LacieUnlam/cartel-led/README.txt

Repositorio GIT del LACIE

NOMBRE PROYECTO:
DESCRIPCION CORTA:
URL WIKI:

Estructura de directorios sugerida del GIT:

* kicad: Archivos PCBs del kicad. 
 ** prototipo1: Colocar gerbers, BOM, pdfs del circuito fabricado, fotos, renders.
 ** prototipo2: Si se hace una segunda fabricación  con correcciones.
 ** hojas_datos: Hojas de datos de los componentes usados en el diseño.
 ** lib: bibliotecas del esquemático.
 ** footp: Módulos del PCB. Unificar los módulos en un único archivo.
    *** 3d: Vistas 3D.
* doc: Documentación asociada directamente al desarrolo y al contenido
       del GIT. No repetir la info de la wiki. Se trata de documentación
       generada por el grupo de trabajo o participantes. 
* info: Información relevante y más importante utilizada para el diseño, que
        ayuda a comprenderlo y justificarlo.
        Es información realizada por terceros (si es propia va en doc).
        Notas de aplicación, documentos de terceros, componentes similares
        evaluados, artículos en revistas, etc.

README.txt: Es este archivo, que debe modificarse y actualizarse con los datos   
            del proyecto.
