LacieUnlam/cartel-led/(list of files, cad)

Other CAD files:
PC/cartelled_pcsoft/CommPort/CommPortRegC6.obj
PC/cartelled_pcsoft/CommPort/IOThread.obj
PC/cartelled_pcsoft/CommPort/TimeOuts.obj
PC/cartelled_pcsoft/CommPort/CommPort.obj
