LacieUnlam/cartel-led/Hard/Kicad_modulo/cartel1.sch

## KiCad design Hard/Kicad_modulo/cartel1.sch (2019-09-17, an earlier design)

Schematic: cartel1.sch

Parts:
C1, C2: 100nf
D1, D2, D3, D4, D5, D6, D7, D8, D9, D10, D11, D12, D13, D14, D15, D16, D17, D18, D19, D20, D21, D22, D23, D24, D25, D26, D27, D28, D29, D30, D31, D32: LED
P1, P2: bus
P3: Dinput
P4: Doutput
U1, U2, U3, U4: 74LS595

Notes on the sheet:
Nota: C1 y C2 son capacitores SMD de encapsulados 1206 pero se pueden soldar encapsulados 0805.
pin1
VISTA DEL CONECTOR LADO COBRE
LOAD
CLK
GND
FILA 4 (INFERIOR)
FILA 3
FILA 2
FILA 1 (SUPERIOR)
BUS CONTROL Y ALIMENTACION
VISTA SUPERIOR LADO COBRE
DETALLE DE MONTAJE
Tornillo 1/8"
PLaca lado LEDs
Placa lado cobre
Separador plástico
Varilla Aluminio roscada
SALIDA DATO
ENTRADA DATO
DATO SERIE SALIDA
DATO SERIE ENTRADA
Soldadura
PINES
Plástico conector 4x2
Plastico conector 4x2
Lado leds
Lado cobre
VISTA LATERAL
Cable plano
Nota: Los integrados se sueldan sin zócalo.
Nota: Los leds se sueldan apoyados sobre el PCB. No se deja espacio entre la placa y el led.
Nota: Los pines se montan hacia el lado del cobre, al revés que lo normal.
Nota: Los conectores de 4x2 se conectan entre sí y hacia el control central por cable plano. Por eso en el PCB se pueden observar líneas sin rutear (la conecta el cable por fuera del PCB).
