LacieUnlam/cartel-led/Hard/control/3 lineas/hard_control.sch

## KiCad design Hard/control/3 lineas/hard_control.sch (2015-05-21)


Parts:
B1: RB1A; rectifier-RB1A
C1: 4.7uf tan
C2, C10: 100nf
C3, C4: 22pf
C5, C6, C7, C8, C9: C
D1: LED
IC1: ATMEGA32-P; DIL40
J1: DB9 FEMALE
LINE_POWER_1, LINE_POWER_2, LINE_POWER_3, LINE_POWER_4: CONN_2
P1: CONN_2
P2, P3, P4, P5: CONN_4X2
PSI1: CONN_3X2
R1, R2, R3: 330
R4: 1K
R5: 500
R6: 10K
Reset1: SW_PUSH
SERIAL_CONN1: CONN_4
U1: MAX202
U2: 7805
U3: 74LS541
X1: CRYSTAL

Connections:
+5V: C1.1, C2.1, C5.2, C7.1, IC1.10 (VCC), IC1.30 (AVCC), PSI1.2, R5.1, R6.1, U1.16 (VCC), U2.VO, U3.20 (VCC)
GND: B1.-, C1.2, C2.2, C3.2, C4.2, C5.1, C9.1, C10.1, D1.2 (K), IC1.11 (GND), IC1.31 (AGND), J1.5, LINE_POWER_1.2 (PM), LINE_POWER_2.2 (PM), LINE_POWER_3.2 (PM), LINE_POWER_4.2 (PM), P2.1, P2.2, P2.4, P3.1, P3.2, P3.4, P4.1, P4.2, P4.4, P5.1, P5.2, P5.4, PSI1.6, Reset1.1, U1.15 (GND), U2.GND, U3.1 (G1), U3.10 (GND), U3.19 (G2)
MISO: IC1.7 ((MISO)PB6), R1.1
MOSI: IC1.6 ((MOSI)PB5), R3.2
unnamed: B1.+, U2.VI
unnamed: B1.AC1, P1.2 (PM)
unnamed: B1.AC2, P1.1
unnamed: C3.1, IC1.12 (XTAL2), X1.2
unnamed: C4.1, IC1.13 (XTAL1), X1.1
unnamed: C6.1, U1.1 (C1+)
unnamed: C6.2, U1.3 (C1-)
unnamed: C7.2, U1.2 (V+)
unnamed: C8.1, U1.4 (C2+)
unnamed: C8.2, U1.5 (C2-)
unnamed: C9.2, U1.6 (V-)
unnamed: D1.1 (A), R5.2
unnamed: LINE_POWER_1.1, P2.3, P2.5, P2.6
unnamed: LINE_POWER_2.1, P3.3, P3.5, P3.6
unnamed: LINE_POWER_3.1, P4.3, P4.5, P4.6
unnamed: LINE_POWER_4.1, P5.3, P5.5, P5.6
unnamed: PSI1.1, R1.2
unnamed: PSI1.3, R2.2
unnamed: PSI1.4, R3.1
unnamed: PSI1.5, R4.2
RXD-RS232: J1.3, U1.8 (R2IN)
RXD-TTL: IC1.14 ((RXD)PD0), U1.9 (R2OUT)
Reset: C10.2, IC1.9 (~RESET), R4.1, R6.2, Reset1.2
SCK: IC1.8 ((SCK)PB7), R2.1
SR_LC: IC1.28 ((TOSC1)PC6), U3.2 (A0), U3.4 (A2), U3.6 (A4), U3.8 (A6)
SR_LC_1: P2.7, U3.18 (Y0)
SR_LC_2: P3.7, U3.16 (Y2)
SR_LC_3: P4.7, U3.14 (Y4)
SR_LC_4: P5.7, U3.12 (Y6)
SR_SC: IC1.27 ((TDI)PC5), U3.3 (A1), U3.5 (A3), U3.7 (A5), U3.9 (A7)
SR_SC_1: P2.8, U3.17 (Y1)
SR_SC_2: P3.8, U3.15 (Y3)
SR_SC_3: P4.8, U3.13 (Y5)
SR_SC_4: P5.8, U3.11 (Y7)
SR_SERIAL_1: IC1.23 ((SDA)PC1), SERIAL_CONN1.1
SR_SERIAL_2: IC1.24 ((TCK)PC2), SERIAL_CONN1.2
SR_SERIAL_3: IC1.25 ((TMS)PC3), SERIAL_CONN1.3
SR_SERIAL_4: IC1.26 ((TDO)PC4), SERIAL_CONN1.4
TXD-RS232: J1.2, U1.7 (T2OUT)
TXD-TTL: IC1.15 ((TXD)PD1), U1.10 (T2IN)

Notes on the sheet:
SPI
PUERTO SERIE
RS232
