LacieUnlam/cartel-led/Hard/control/full/rescue-backup/hard_control-2019-09-07-13-09-32.sch

## KiCad design Hard/control/full/rescue-backup/hard_control-2019-09-07-13-09-32.sch (2015-10-20)

Schematic: hard_control-2019-09-07-13-09-32.sch

Parts:
B1: RB1A; rectifier-RB1A
C1: 4.7uf tan
C2, C10: 100nf
C3, C4: 22pf
C5, C6, C7, C8, C9: C
D1: LED
DIGI_PWR_1: CONN_2
IC1: ATMEGA32-P; DIL40
J1: DB9 FEMALE
LINE_POWER_1, LINE_POWER_2, LINE_POWER_3, LINE_POWER_4, LINE_POWER_5, LINE_POWER_6: CONN_2
P1, P2, P3, P4, P5, P6: CONN_5X2
PSI1: CONN_3X2
R1, R2, R3: 330
R4: 1K
R5: 500
R6: 10K
Reset1: SW_PUSH
SERIAL_CONN1: CONN_6
U1: MAX202
U2: 7805
U3, U4: 74LS541
X1: CRYSTAL

Notes on the sheet:
SPI
PUERTO SERIE
RS232
