LacieUnlam/cartel-led/Firm/Src/ArialBlack_14.h

/*
 *
 * arialblack_14
 *
 * created with FontCreator
 * written by F. Maximilian Thiele
 *
 * http://www.apetech.de/fontCreator
 * me@apetech.de
 *
 * File Name           : ArialBlack_14.h
 * Date                : 30.10.2013
 * Font size in bytes  : 9762
 * Font width          : 10
 * Font height         : 14
 * Font first char     : 32
 * Font last char      : 128
 * Font used chars     : 96
 *
 * The font data are defined as
 *
 * struct _FONT_ {
 *     uint16_t   font_Size_in_Bytes_over_all_included_Size_it_self;
 *     uint8_t    font_Width_in_Pixel_for_fixed_drawing;
 *     uint8_t    font_Height_in_Pixel_for_all_characters;
 *     unit8_t    font_First_Char;
 *     uint8_t    font_Char_Count;
 *
 *     uint8_t    font_Char_Widths[font_Last_Char - font_First_Char +1];
 *                  // for each character the separate width in pixels,
 *                  // characters < 128 have an implicit virtual right empty row
 *
 *     uint8_t    font_data[];
 *                  // bit field of all characters
 */

#include <inttypes.h>
#include <avr/pgmspace.h>

#ifndef ARIALBLACK_14_H
#define ARIALBLACK_14_H

#define ARIALBLACK_14_WIDTH 10
#define ARIALBLACK_14_HEIGHT 14

const static uint8_t arialblack_14[] PROGMEM = {
    0x26, 0x22, // size
    0x0A, // width
    0x0E, // height
    0x20, // first char
    0x60, // char count
    
    // char widths
    0x00, 0x03, 0x07, 0x08, 0x07, 0x0C, 0x0A, 0x03, 0x05, 0x05, 
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
    0xF0, 0xFC, 0xFC, 0x0E, 0x06, 0x66, 0x66, 0xEE, 0xEC, 0xE8, 0x00, 0x0C, 0x0C, 0x1C, 0x18, 0x18, 0x18, 0x1C, 0x0C, 0x0C, // 71
    0xFE, 0xFE, 0xFE, 0x60, 0x60, 0x60, 0x60, 0xFE, 0xFE, 0xFE, 0x1C, 0x1C, 0x1C, 0x00, 0x00, 0x00, 0x00, 0x1C, 0x1C, 0x1C, // 72
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
    
};

#endif
