LacieUnlam/cartel-led/Firm/Src/BroadwayBT_8.h

/*
 *
 * BroadwayBT_8
 *
 * created with FontCreator
 * written by F. Maximilian Thiele
 *
 * http://www.apetech.de/fontCreator
 * me@apetech.de
 *
 * File Name           : BroadwayBT_8.h
 * Date                : 25.09.2012
 * Font size in bytes  : 4062
 * Font width          : 10
 * Font height         : 9
 * Font first char     : 32
 * Font last char      : 128
 * Font used chars     : 96
 *
 * The font data are defined as
 *
 * struct _FONT_ {
 *     uint16_t   font_Size_in_Bytes_over_all_included_Size_it_self;
 *     uint8_t    font_Width_in_Pixel_for_fixed_drawing;
 *     uint8_t    font_Height_in_Pixel_for_all_characters;
 *     unit8_t    font_First_Char;
 *     uint8_t    font_Char_Count;
 *
 *     uint8_t    font_Char_Widths[font_Last_Char - font_First_Char +1];
 *                  // for each character the separate width in pixels,
 *                  // characters < 128 have an implicit virtual right empty row
 *
 *     uint8_t    font_data[];
 *                  // bit field of all characters
 */

#include <inttypes.h>
#include <avr/pgmspace.h>

#ifndef BROADWAYBT_8_H
#define BROADWAYBT_8_H

#define BROADWAYBT_8_WIDTH 10
#define BROADWAYBT_8_HEIGHT 9

const static uint8_t BroadwayBT_8[] PROGMEM = {
    0x0F, 0xDE, // size
    0x0A, // width
    0x09, // height
    0x20, // first char
    0x60, // char count
    
    // char widths
    0x00, 0x02, 0x03, 0x06, 0x04, 0x06, 0x06, 0x01, 0x02, 0x02, 
    0x03, 0x05, 0x02, 0x03, 0x02, 0x03, 0x05, 0x04, 0x05, 0x05, 
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
    0x7E, 0x7E, 0x7E, 0x0A, 0x0A, 0x00, 0x00, 0x00, 0x00, 0x00, // 70
    0x3C, 0x7E, 0x7E, 0x42, 0x54, 0x30, 0x00, 0x00, 0x00, 0x00, 0x00, 0x00, // 71
    0x7E, 0x7E, 0x7E, 0x04, 0x04, 0x7E, 0x00, 0x00, 0x00, 0x00, 0x00, 0x00, // 72
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
    
};

#endif
