LacieUnlam/cartel-led/Firm/Src/BanckGothicLtBT_8.h

/*
 *
 * BanckGothicLtBT_8
 *
 * created with FontCreator
 * written by F. Maximilian Thiele
 *
 * http://www.apetech.de/fontCreator
 * me@apetech.de
 *
 * File Name           : BanckGothicLtBT_8.h
 * Date                : 25.09.2012
 * Font size in bytes  : 2958
 * Font width          : 10
 * Font height         : 8
 * Font first char     : 32
 * Font last char      : 128
 * Font used chars     : 96
 *
 * The font data are defined as
 *
 * struct _FONT_ {
 *     uint16_t   font_Size_in_Bytes_over_all_included_Size_it_self;
 *     uint8_t    font_Width_in_Pixel_for_fixed_drawing;
 *     uint8_t    font_Height_in_Pixel_for_all_characters;
 *     unit8_t    font_First_Char;
 *     uint8_t    font_Char_Count;
 *
 *     uint8_t    font_Char_Widths[font_Last_Char - font_First_Char +1];
 *                  // for each character the separate width in pixels,
 *                  // characters < 128 have an implicit virtual right empty row
 *
 *     uint8_t    font_data[];
 *                  // bit field of all characters
 */

#include <inttypes.h>
#include <avr/pgmspace.h>

#ifndef BANCKGOTHICLTBT_8_H
#define BANCKGOTHICLTBT_8_H

#define BANCKGOTHICLTBT_8_WIDTH 10
#define BANCKGOTHICLTBT_8_HEIGHT 8

const static uint8_t BanckGothicLtBT_8[] PROGMEM = {
    0x0B, 0x8E, // size
    0x0A, // width
    0x08, // height
    0x20, // first char
    0x60, // char count
    
    // char widths
    0x00, 0x01, 0x01, 0x05, 0x04, 0x06, 0x05, 0x01, 0x02, 0x02, 
    0x03, 0x05, 0x01, 0x02, 0x01, 0x02, 0x04, 0x02, 0x04, 0x04, 
    0x05, 0x04, 0x04, 0x04, 0x04, 0x04, 0x01, 0x01, 0x05, 0x05, 
    0x05, 0x03, 0x07, 0x05, 0x04, 0x04, 0x05, 0x04, 0x04, 0x05, 
    0x05, 0x01, 0x04, 0x05, 0x04, 0x05, 0x05, 0x05, 0x04, 0x05, 
    0x04, 0x04, 0x05, 0x04, 0x05, 0x06, 0x05, 0x05, 0x04, 0x02, 
    0x02, 0x02, 0x05, 0x04, 0x02, 0x05, 0x04, 0x04, 0x04, 0x04, 
    0x03, 0x04, 0x04, 0x01, 0x03, 0x04, 0x03, 0x04, 0x04, 0x04, 
    0x04, 0x04, 0x03, 0x04, 0x04, 0x04, 0x04, 0x06, 0x04, 0x05, 
    0x04, 0x03, 0x01, 0x03, 0x05, 0x04, 
    
    // font data
    0x2C, // 33
    0x03, // 34
    0x34, 0x1C, 0x37, 0x1F, 0x14, // 35
    0x5C, 0x7E, 0x34, 0x34, // 36
    0x0C, 0x2C, 0x10, 0x08, 0x34, 0x30, // 37
    0x30, 0x2C, 0x34, 0x14, 0x30, // 38
    0x03, // 39
    0x18, 0x24, // 40
    0x24, 0x18, // 41
    0x08, 0x04, 0x08, // 42
    0x08, 0x08, 0x3E, 0x08, 0x08, // 43
    0x60, // 44
    0x10, 0x10, // 45
    0x20, // 46
    0x38, 0x04, // 47
    0x3C, 0x24, 0x24, 0x3C, // 48
    0x04, 0x3C, // 49
    0x3C, 0x34, 0x34, 0x3C, // 50
    0x24, 0x24, 0x2C, 0x34, // 51
    0x18, 0x18, 0x14, 0x3C, 0x10, // 52
    0x2C, 0x2C, 0x2C, 0x38, // 53
    0x38, 0x34, 0x34, 0x30, // 54
    0x0C, 0x24, 0x1C, 0x04, // 55
    0x34, 0x2C, 0x2C, 0x34, // 56
    0x0C, 0x2C, 0x2C, 0x1C, // 57
    0x28, // 58
    0x68, // 59
    0x10, 0x18, 0x28, 0x28, 0x24, // 60
    0x14, 0x14, 0x14, 0x14, 0x14, // 61
    0x24, 0x28, 0x28, 0x18, 0x10, // 62
    0x0C, 0x34, 0x0C, // 63
    0x3C, 0x62, 0x59, 0x55, 0x5D, 0x53, 0x0E, // 64
    0x20, 0x1C, 0x14, 0x18, 0x20, // 65
    0x3C, 0x2C, 0x2C, 0x34, // 66
    0x3C, 0x24, 0x24, 0x3C, // 67
    0x3C, 0x24, 0x24, 0x24, 0x18, // 68
    0x3C, 0x2C, 0x2C, 0x24, // 69
    0x3C, 0x0C, 0x0C, 0x04, // 70
    0x3C, 0x24, 0x24, 0x34, 0x34, // 71
    0x3C, 0x08, 0x08, 0x08, 0x3C, // 72
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
    
};

#endif
