LacieUnlam/cartel-led/Firm/Src/Arial_8.h

/*
 *
 * Arial_8
 *
 * created with FontCreator
 * written by F. Maximilian Thiele
 *
 * http://www.apetech.de/fontCreator
 * me@apetech.de
 *
 * File Name           : Arial_8.h
 * Date                : 25.09.2012
 * Font size in bytes  : 2750
 * Font width          : 10
 * Font height         : 8
 * Font first char     : 32
 * Font last char      : 128
 * Font used chars     : 96
 *
 * The font data are defined as
 *
 * struct _FONT_ {
 *     uint16_t   font_Size_in_Bytes_over_all_included_Size_it_self;
 *     uint8_t    font_Width_in_Pixel_for_fixed_drawing;
 *     uint8_t    font_Height_in_Pixel_for_all_characters;
 *     unit8_t    font_First_Char;
 *     uint8_t    font_Char_Count;
 *
 *     uint8_t    font_Char_Widths[font_Last_Char - font_First_Char +1];
 *                  // for each character the separate width in pixels,
 *                  // characters < 128 have an implicit virtual right empty row
 *
 *     uint8_t    font_data[];
 *                  // bit field of all characters
 */

#include <inttypes.h>
#include <avr/pgmspace.h>

#ifndef ARIAL_8_H
#define ARIAL_8_H

#define ARIAL_8_WIDTH 10
#define ARIAL_8_HEIGHT 8

static uint8_t Arial_8[] PROGMEM = {
    0x0A, 0xBE, // size
    0x0A, // width
    0x08, // height
    0x20, // first char
    0x60, // char count
    
    // char widths
    0x00, 0x01, 0x01, 0x04, 0x04, 0x07, 0x05, 0x01, 0x02, 0x02, 
    0x01, 0x04, 0x01, 0x02, 0x01, 0x02, 0x04, 0x02, 0x04, 0x04, 
    0x04, 0x04, 0x04, 0x04, 0x04, 0x04, 0x01, 0x01, 0x04, 0x04, 
    0x04, 0x04, 0x08, 0x05, 0x04, 0x05, 0x04, 0x04, 0x04, 0x06, 
    0x04, 0x01, 0x03, 0x04, 0x03, 0x05, 0x04, 0x06, 0x04, 0x06, 
    0x04, 0x05, 0x05, 0x04, 0x05, 0x07, 0x05, 0x05, 0x05, 0x01, 
    0x02, 0x02, 0x03, 0x04, 0x01, 0x04, 0x03, 0x04, 0x04, 0x04, 
    0x02, 0x04, 0x03, 0x01, 0x01, 0x03, 0x01, 0x05, 0x03, 0x04, 
    0x03, 0x04, 0x02, 0x04, 0x02, 0x03, 0x04, 0x06, 0x04, 0x04, 
    0x04, 0x02, 0x01, 0x02, 0x04, 0x04, 
    
    // font data
    0x3F, // 33
    0x03, // 34
    0x30, 0x0E, 0x3C, 0x07, // 35
    0x12, 0x3F, 0x29, 0x3A, // 36
    0x06, 0x09, 0x36, 0x0C, 0x32, 0x28, 0x10, // 37
    0x10, 0x2A, 0x2D, 0x32, 0x28, // 38
    0x03, // 39
    0x3C, 0x42, // 40
    0x81, 0x7E, // 41
    0x03, // 42
    0x08, 0x08, 0x1E, 0x08, // 43
    0x20, // 44
    0x10, 0x10, // 45
    0x20, // 46
    0x38, 0x06, // 47
    0x1E, 0x21, 0x21, 0x1E, // 48
    0x02, 0x3F, // 49
    0x22, 0x31, 0x29, 0x26, // 50
    0x12, 0x21, 0x21, 0x3E, // 51
    0x18, 0x14, 0x1E, 0x10, // 52
    0x12, 0x25, 0x25, 0x39, // 53
    0x1E, 0x29, 0x25, 0x3A, // 54
    0x01, 0x31, 0x0D, 0x03, // 55
    0x1A, 0x25, 0x29, 0x3E, // 56
    0x06, 0x29, 0x29, 0x1E, // 57
    0x24, // 58
    0x24, // 59
    0x08, 0x0C, 0x14, 0x14, // 60
    0x04, 0x0C, 0x0C, 0x04, // 61
    0x12, 0x14, 0x14, 0x08, // 62
    0x02, 0x01, 0x39, 0x06, // 63
    0x3C, 0x42, 0xBE, 0xA5, 0x95, 0xAD, 0x72, 0x0C, // 64
    0x30, 0x0E, 0x11, 0x0E, 0x30, // 65
    0x3F, 0x29, 0x25, 0x1A, // 66
    0x1C, 0x22, 0x21, 0x21, 0x22, // 67
    0x3F, 0x21, 0x21, 0x1E, // 68
    0x3F, 0x29, 0x29, 0x21, // 69
    0x1F, 0x09, 0x01, 0x01, // 70
    0x0C, 0x32, 0x21, 0x29, 0x29, 0x1A, // 71
    0x1E, 0x08, 0x08, 0x3F, // 72
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
    
};

#endif
