LacieUnlam/cartel-led/(commit log)

2014-05-23 Programa funcionando, especializado para la robolucha. Version robolucha 2013. -Cronometro de round. -Cronometro de tiempo de "actividad incierta" entre contrincantes. -Comando para mostrar dos texto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
2014-05-30 en agregado de comando pausa
2014-05-30 Agregado funcion pausa y eco de contadores por el serial. No ensayado aun.
2014-05-31 pausa y replica de contadores por puerto serial, probados en proteus.
2014-06-10 Terminado,probado:Cronos configurables por trama mm,ss,ccc,s Terminado,probado:Tramas de estado de variables en mm,ss,ccc,s Detectado:Perdida de caracteres en recepción. Detectado:Poco atractiva vist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
2014-10-23 Modificaciones hechas para cartel de 8x6 modulos: *Reposicionado de contadores y nombres de oponentes.
2015-05-07 Agregado: -Recursos para control de brillo. Nota: Se perdió la posibilidad de preparar la matriz del cartel en memoria antes de su representación en el cartel, ya que esta matriz esta a su vez trabaj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
    A Resolver:
    -Reponer la capacidad de dibujar por completo la matriz antes de
    actualizar en el cartel.
    Nota: Agregando .gitignore al control de versiones, después de un
    aparentemente fallido intento en commit anterior.
    [MultiSIPOReg.h, cartel.c, cartel.h, cartel_comm.c, cartel_comm.h, main.c]
2015-05-11 Agregado el README con instrucciones iniciales.
2015-05-11 Resuelto: -Repuesta la capacidad de dibujar por completo la matriz antes de actualizar en el cartel.
    Nota: Eliminado cartel.c.bak del control de versiones.
2015-05-20 Agrego el PCB del cartel del LEDs y su documentación.
    [cartel1.brd, cartel1.sch, cartel1_3.brd]
2015-05-21 -Agregado: PCB de placas de control y soft de PC. -Modificado: Reordenamiento de carpetas en el repositorio.
    Nota: Versión commitiada del firm posee modificaciones sin terminar.
    [CommPort.obj, CommPortRegC6.obj, IOThread.obj, TimeOuts.obj, cartel1.brd, cartel1.sch, cartel1_3.brd, hard_control.brd]
2015-05-21 Borro directorio Src con el .bak adentro.
2015-05-21 -Modificado: Eliminado del versionado el descriptor de proyecto Builder (.bpr) de la aplicacion de PC, por poseer direcciones de acceso a librerías que son locales.
2015-06-06 Firm: Inicio rama vent_text. Rama en la que se implementa la representación en el cartel de un fragmento de texto, a nivel de linea de pixeles. Es necesario para una posterior implementación de un sc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
2015-06-08 Terminado: Representación de un fragmento de texto
2015-06-16 Agregado: Implementación de scroll de texto basico.
2015-06-18 Firm: Inicio de agregado de comandos para texto automático
2015-06-28 Firm: Terminado: -Comandos de ingreso y representación de mensajes en EEPROM. Modificado: -Asignación de comandos brillo
2015-07-04 Firm: -Modificado: Presentación de texto EEPROM. Primer linea fija, segunda scroleada.
2015-07-04 Firm: -Modificado: -Presentación de texto EEPROM. Primer linea fija, segunda scroleada. -255 caracteres de texto permitido -La activación de modo "información" detiene contador robolucha si está acti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
2015-10-15 -Adaptada codificación win a utf8 -Inicio de agregado de destello de leds tatami en cuenta regresiva.
2015-10-20 -Primer propuesta de modificaciones para destello de LEDs de tatami, sin probar. -Archivos kicad adaptados a vesion 2015
    [hard_control.sch]
2015-10-29 -Modificado: los LEDs se mantienen prendidos durante todo el tiempo de operación del cartel, excepto cuando cronometra (se apaga), o cuando se realiza la regresiva (parpadea a cada segundo).
2019-09-09 Actualización de los esquemáticos a kicad 5.
    [cartel1-2019-08-31-13-06-42.sch, cartel1-2019-08-31-13-07-36.sch, cartel1-2019-08-31-13-10-29.sch, cartel1-2019-09-07-13-13-01.sch, cartel1-2019-09-07-13-13-38.sch, cartel1-2019-09-07-13-15-50.sch, cartel1.sch, hard_control-2019-09-07-13-09-32.sch]
2019-09-17 Agrego presentación de la actividad a uea2015.
2026-05-23 Agrego paper uea2015
    Agrego paper presentado al Congreso de Microelectrónica Aplicada 2015.
